DanyGhostt/Estacion-de-Control-y-Telemetr-a-IoT/Receptor_1_ARduino/assets/triceratops.gif

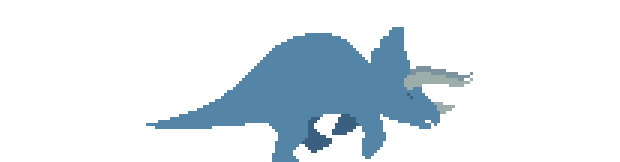
Receptor_1_ARduino/assets/triceratops.gif
