DanyGhostt/Estacion-de-Control-y-Telemetr-a-IoT/STM_TO_ESP32_UART/STM_TO_ESP32_UART.ioc

Mcu.UserName=STM32F446RETx
PA13.Signal=SYS_JTMS-SWDIO
PA14.Signal=SYS_JTCK-SWCLK
PB10.Signal=USART3_TX
PB3.Signal=SYS_JTDO-SWO
PC5.Signal=USART3_RX
