DanyGhostt/Estacion-de-Control-y-Telemetr-a-IoT/Receptor_1_ARduino/src/triceratops_gif_data.cpp

#include "triceratops_gif.h"

extern const uint8_t triceratops_gif_data[] = {
    0x47, 0x49, 0x46, 0x38, 0x39, 0x61, 0xD7, 0x00, 0x6E, 0x00, 0x86, 0x00,
    0x00, 0x00, 0x00, 0x00, 0x54, 0x85, 0xA7, 0x9B, 0xAB, 0xA8, 0x54, 0x85,
    0xA7, 0x5B, 0x91, 0xB6, 0x54, 0x85, 0xA7, 0x3A, 0x60, 0x7E, 0x54, 0x85,
    0xA7, 0x7F, 0x7F, 0x7F, 0x53, 0x84, 0xA7, 0x3C, 0x62, 0x82, 0x54, 0x85,
    0xA8, 0x67, 0x98, 0x99, 0x3F, 0x7F, 0xBF, 0x7B, 0x92, 0x9D, 0x53, 0x84,
    0xA6, 0x39, 0x5E, 0x7D, 0x66, 0x99, 0xCC, 0x00, 0xFF, 0xFF, 0x4B, 0x78,
    0x9A, 0xFF, 0xFF, 0xFF, 0x00, 0x7F, 0x7F, 0x6C, 0x96, 0xAF, 0x53, 0x7E,
    0xA8, 0xA4, 0xB4, 0xAE, 0x3F, 0x7F, 0x7F, 0x55, 0x55, 0xAA, 0x61, 0x9A,
    0xC2, 0x7F, 0x7F, 0xFF, 0x82, 0x9A, 0xA4, 0x55, 0xAA, 0xAA, 0x54, 0x89,
    0xA6, 0x41, 0x6A, 0x8B, 0x9A, 0xAB, 0xAB, 0x00, 0x00, 0xFF, 0x33, 0x66,
    0x99, 0x35, 0x65, 0x6E, 0x33, 0x5A, 0x7B, 0x3B, 0x62, 0x7D, 0x77, 0x93,
    0xAA, 0x33, 0x66, 0xCC, 0x7B, 0x92, 0x9B, 0x3A, 0x60, 0x7E, 0xB5, 0xB8,
    0xB8, 0x3A, 0x5E, 0x7E, 0xA0, 0xAE, 0xA9, 0x4B, 0x91, 0xAF, 0x3C, 0x62,
    0x82, 0x9B, 0xB4, 0xB0, 0x80, 0x95, 0x9E, 0x7B, 0x92, 0x9C, 0xA6, 0xAB,
    0xAB, 0x9B, 0xAC, 0xA9, 0x9C, 0xAC, 0xA8, 0x39, 0x5E, 0x7E, 0xB6, 0xC7,
    0xC2, 0x66, 0x66, 0x99, 0x9C, 0xAB, 0xA9, 0x39, 0x61, 0x7F, 0x3B, 0x3B,
    0x76, 0x4F, 0x95, 0x95, 0x39, 0x5D, 0x7C, 0x56, 0x8A, 0x91, 0x4E, 0x7F,
    0xA2, 0x3B, 0x62, 0x81, 0x3D, 0x65, 0x85, 0x55, 0x7F, 0x7F, 0x79, 0x8B,
    0x98, 0x85, 0x9A, 0xA6, 0x99, 0x99, 0x99, 0x7F, 0xBF, 0xBF, 0x3F, 0x7F,
    0x9F, 0x48, 0x6D, 0x91, 0x9D, 0xAB, 0xA8, 0x7C, 0x92, 0x9D, 0x49, 0x76,
    0x97, 0x53, 0x7F, 0xA3, 0x3A, 0x61, 0x81, 0x3B, 0x5F, 0x80, 0x39, 0x5D,
    0x7D, 0xA5, 0xB6, 0xB2, 0x7F, 0x7F, 0xBF, 0x55, 0x55, 0x55, 0x76, 0x8F,
    0x9B, 0x7F, 0x00, 0x7F, 0xA0, 0xB0, 0xAC, 0x55, 0xAA, 0xFF, 0x74, 0x8F,
    0x9E, 0x64, 0x8A, 0xA6, 0x65, 0x8F, 0xA7, 0x63, 0x8D, 0xA7, 0x7B, 0x90,
    0x9B, 0x7B, 0x92, 0x9D, 0x49, 0x73, 0x94, 0x58, 0x79, 0x9B, 0x7C, 0x95,
    0xA1, 0x78, 0x98, 0xA8, 0x4C, 0x66, 0x7F, 0x6A, 0xA7, 0xD2, 0x33, 0x99,
    0xCC, 0x33, 0x99, 0x99, 0x9E, 0xAB, 0xA7, 0x9D, 0xAB, 0xA8, 0x9F, 0xB0,
    0xAC, 0x99, 0xCC, 0x99, 0x3B, 0x64, 0x84, 0x3A, 0x60, 0x7F, 0x3C, 0x60,
    0x7E, 0xA1, 0xAF, 0xA8, 0x3A, 0x5F, 0x80, 0x38, 0x55, 0x8D, 0xA6, 0xB6,
    0xB1, 0xAC, 0xBB, 0xB4, 0x3B, 0x5F, 0x7F, 0x2A, 0x55, 0x55, 0x5B, 0x91,
    0xB5, 0x00, 0xFF, 0x00, 0x00, 0x00, 0x00, 0x00, 0x00, 0x00, 0x00, 0x00,
    0x00, 0x00, 0x00, 0x00, 0x00, 0x00, 0x00, 0x00, 0x00, 0x00, 0x00, 0x00,
    0x00, 0x00, 0x00, 0x00, 0x00, 0x00, 0x00, 0x00, 0x00, 0x00, 0x00, 0x00,
    0x00, 0x21, 0xFF, 0x0B, 0x4E, 0x45, 0x54, 0x53, 0x43, 0x41, 0x50, 0x45,
    0x32, 0x2E, 0x30, 0x03, 0x01, 0x00, 0x00, 0x00, 0x21, 0xF9, 0x04, 0x09,
    0x04, 0x00, 0x00, 0x00, 0x2C, 0x00, 0x00, 0x00, 0x00, 0xD7, 0x00, 0x6E,
    0x00, 0x00, 0x08, 0xFF, 0x00, 0x01, 0x08, 0x1C, 0x48, 0xB0, 0xA0, 0xC1,
    0x83, 0x08, 0x13, 0x2A, 0x5C, 0xC8, 0xB0, 0xA1, 0xC3, 0x87, 0x10, 0x23,
    0x4A, 0x9C, 0x48, 0xB1, 0xA2, 0xC5, 0x8B, 0x18, 0x33, 0x6A, 0xDC, 0xC8,
    0xB1, 0xA3, 0xC7, 0x8F, 0x20, 0x43, 0x8A, 0x1C, 0x49, 0xB2, 0xA4, 0xC9,
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
};

extern const size_t triceratops_gif_data_size = sizeof(triceratops_gif_data);
