DanyGhostt/Estacion-de-Control-y-Telemetr-a-IoT/(commit log)

2026-10-07 feat: Estacion de Control HMI y Telemetria IoT (STM32 + ESP32)
2026-10-07 docs: actualizar fotos rotadas, diagrama de arquitectura y pantallas LVGL/QR
2026-10-07 Replace WiFi credentials with placeholders
    Updated WiFi credentials to placeholders for security.
    [main.cpp]
